pe4wj/vlfrx/rotary/rotary.ino

/*
 * Example using the Rotary library, dumping integers to the serial
 * port. The integers increment or decrement depending on the direction
 * of rotation.
 *
 * This example uses interrupts rather than polling.
 */

#include <Rotary.h>

// Rotary encoder is wired with the common to ground and the two
// outputs to pins 2 and 3.
Rotary rotary = Rotary(1, 0);

// Counter that will be incremented or decremented by rotation.
int counter = 0;

void setup() {
  Serial.begin(9600);
  attachInterrupt(0, rotate, CHANGE);
  attachInterrupt(1, rotate, CHANGE);
}

void loop() {
}

// rotate is called anytime the rotary inputs change state.
void rotate() {
  unsigned char result = rotary.process();
  if (result == DIR_CW) {
    counter++;
    Serial.println(counter);
  } else if (result == DIR_CCW) {
    counter--;
    Serial.println(counter);
  }
}
